kmfras/lickometer/Janak Lab SfN CeA Alcohol Poster 2019.pdf

# Encoding and enhancement of the motivation to consume alcohol by the central nucleus of the amygdala

*These authors contributed equally to this project 1: Department of Psychological and Brain Sciences, Krieger School of Arts and Sciences, 2: The Solomon H. Snyder Department of Neuroscience, Johns Hopkins School of Medicine, 3: Kavli Neuroscience Discovery Institute, Johns Hopkins School of Medicine, Johns Hopkins University
Introduction | Results

# Summary

# Methods

# Kurt M. Fraser¹*, Tabitha H. Kim¹*, David J. Ottenheimer² , & Patricia H. Janak¹,2,3

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
er Clu

ster

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
er Clu

ster

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
er Clu

ster

0

50

100

150

Clu

sters

0

50

100

150

Clu

sters

0

50

100

150

Clu

sters

Maltodextrin vs.
Maltodextrin

Sucrose vs.
Maltodextrin

Sucrose vs.
A | B | C | Maltodextrin
D | E | F

Motivation

Palatability
Maltodextrin vs.
Maltodextrin

Sucrose vs.
Maltodextrin

Sucrose vs.
Maltodextrin

ChR2 GFP
Laser Option
Control Option

### Optogenetic stimulation of the central amygdala alters preference between two objectively equal rewards

- Central amygdala neurons are modulated by the consumption of alcohol, both movements related to the pursuit of alcohol and the licking action required to consume alcohol.
- Neurons within the central amygdala are tuned to the licking cycle and exhibit rhythmic firing during alcohol consumption.
- Closed-loop optogenetic excitation of the central amygdala promoted consumption of the laser-paired option when the other option was equivalent. Stimulation was able to increase alcohol consumption when sucrose was available and enhance motivation to consume adulterated bitter alcohol.
- We observed modest self-stimulation of the central amygdala, perhaps owing to alcohol-induced plasticity resulting from voluntary alcohol consumption.

The central amygdala has been implicated in the promotion of alcohol consumption primarily following dependence through processes associated with the generation of a prolonged negative affective state that is alleviated by alcohol consumption.

It has remained unclear, however, how the central amygdala is involved in the initial motivation to consume alcohol prior to the onset of physical dependence.

If the central amygdala contributes to alcohol consumption produced by appetitive motivational processes, then it is possible that prolonged alcohol consumption can co-opt these appetitive mechanisms and provide a mechanism for the transition to compulsive alcohol consumption and alcohol abuse.

The central amygdala is an ideal site for such hypothesized alcohol-induced plasticity as it receives direct input from brainstem, thalamic and cortical gustatory regions and projects to affective processing structures like the bed nucleus of the stria terminalis, homeostatic control centers like the lateral hypothalamus, and brainstem taste centers such as the parabrachial nucleus and nucleus of the solitary tract.

We investigated the involvement of the central amygdala in the control of alcohol consumption by making use of in vivo electrophysiology to identify correlates of alcohol consumption in the central amygdala and optogenetics to tease apart mechanisms by which the central amygdala may promote the consumption of alcohol despite the availability of more preferred options.

Supported by NIH Grants R01 AA026306, AA027213 to PHJ and F31 DA046136 to KMF

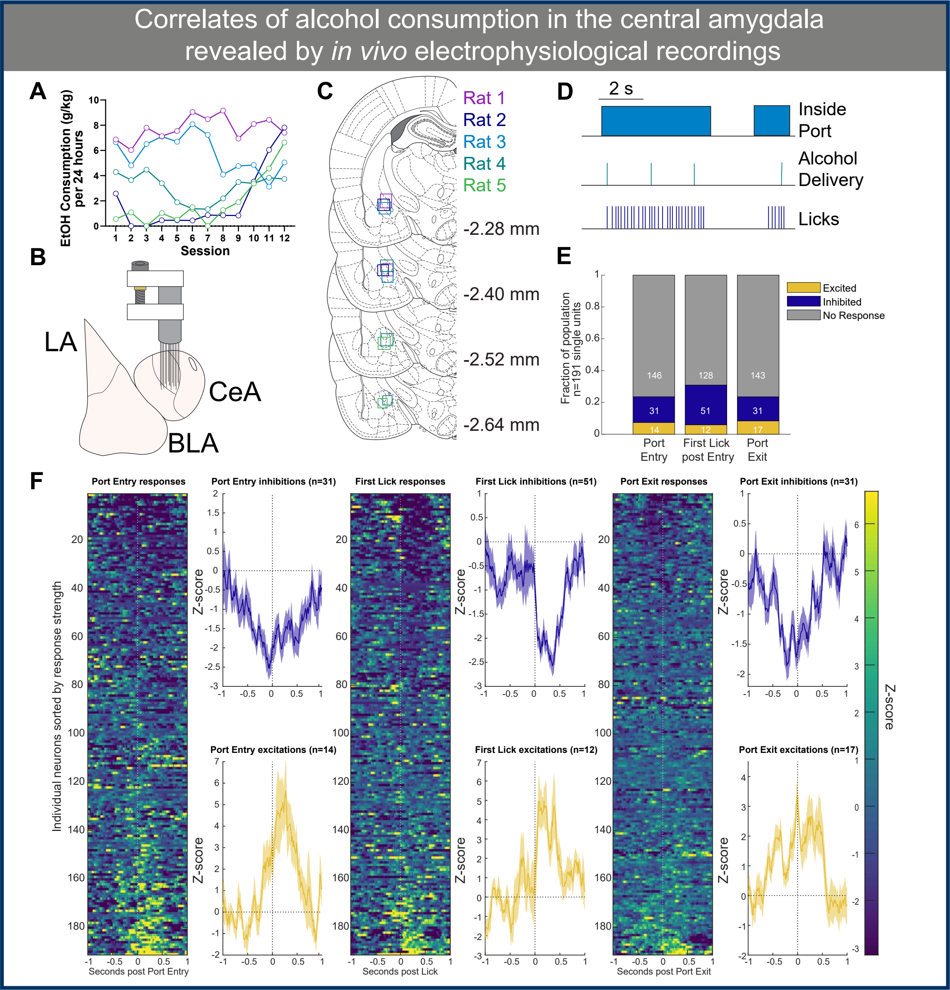
[picture p1: figure]
Rat 1 Rat 2 Rat 3 Rat 4 Rat 5; Port Entry responses; Seconds post Port Entry; First Lick responses; Seconds post Lick; Port Exit responses; Seconds post Port Exit; Z-score; Port Entry inhibitions (n=31); Port Entry excitations (n=14); First Lick inhibitions (n=51); First Lick excitations (n=12); Port Exit inhibitions (n=31); Port Exit excitations (n=17); CeA BLA; Inside Port Alcohol Delivery; Licks; Session; tio; Port Entry; First Lick post Entry; Port Exit; Fraction of population; Excited Inhibited No Response; n=191 single units

### Correlates of alcohol consumption in the central amygdala revealed by in vivo electrophysiological recordings

@Kurt_Fraser
@JanakLab
kfraser3@jhu.edu

Individual neurons sorted by response strength

-2.16 mm

-2.28 mm

-2.40 mm

-2.52 mm

-2.64 mm

-2.76 mm

GFP

ChR2

A B

C

GFP | ChR2-eYFP

DAPI
GFP

1 2 3 4 5 6 7 8 9 10 11 12 13 14 15

0

5

10

Session

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
ChR2

n=6

n=8

DAPI
YFP
5x | 10x
CeA | BLA | BLA

CeA

473 nm
8-12 mW
1s, 20 Hz
A | B | Example ChR2 Rat

Example GFP Rat

10% Ethanol
+ Laser

10% Ethanol

10% Ethanol
+ Laser

10% Ethanol

Time (seconds)

0 | 500 | 1000 | 1500 | 1800
H2O | Malt
0.6062
0.3185
0.2329
0.0856
0.2893

0.1728
0.3795
0.1246

0.1655
0.3453
0.448
| 0.4112

0.0351

H2O | Malt
0.1301
0.042
0.1048
0.0568
0.0312

0.0063
0.3265
0.0374

0.0641
0.2187
0.3417
| 0.0078

0.0934

Laser Paired
Bottle

14.2% Sucrose

10% Ethanol

10% Ethanol
+ 100 μM Quinine

Non-Laser Paired Bottle

14.2% Sucrose | 10% Ethanol | 10% Ethanol + 100 μM Quinine

C D

ChR2 GFP
Laser Option
Control Option

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
14.2% Sucrose

10% Ethanol

10% Ethanol
+ 100 μM Quinine
Motivation | Palatability

Suc
Alc
AlcQ

Laser

Suc | Alc | AlcQ

No Laser

Total Clusters

0

0.5

1
Suc
Alc
AlcQ

Laser

Suc | Alc | AlcQ

No Laser

Average Licks in Clusters

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
1000

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
ChR2 GFP
Active Responses
Inactive Responses

0

1000

2000

3000

4000

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
1000

1500

2000

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
1000

2000

3000

4000

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
A | B | C
D | E | F
G | H | I

Empty Bottles

Water in Bottles

FR1 Nose Poke

E F

### Central amygdala neurons are entrained to the frequency of licking that occurs during alcohol consumption

### Closed-loop optogenetic stimulation of the central amygdala enhances motivation to consume the preferred available option

### Optogenetic control of the central amygdala in rats with a history of alcohol intake in the homecage

### Optogenetic self-stimulation of the central amygdala is modest in rats with a history of alcohol consumption

How much more does stimulation enhance laser bottle preference in ChR2 rats relative to GFP rats? effect size | effect size

Do you want the code and
instructions for the lickometer? A reprint of this poster?
How-to guide, arduino code, and MATLAB analysis code
for lickometer generated data all available at :
github.com/kmfras/lickometer

Number of neurons

Licking Coherence
Tongue out
n=68

Tongue in
n=34

Seconds from lick

Coherent neurons (n=104) Sorted by
Time of Post Lick Excitation
-0.5 | 0 | 0.5
Time (sec)

0

10

20

SPK23a
Coherence = 0.9587
Raster aligned to
Inidividual Licks Firing Rate (Hz)

A

D E

B Median Coherence
0.39

C

Normalized Activity

0 0.1 0.2 0.3 0.4 0.5 0.6 0.7 0.8 0.9 1 0

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
-0.3 | -0.2 | -0.1 | 0 | 0.1 | 0.2 | 0.3

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
0 | 0.02 0.04 0.06 0.08 0.1 | 0.12 0.14 0

5

10

15

20

25

30

Number of neurons

Time (s) of peak activity relative to tongue contacting liquid

*

* | *

*

*

*

* *

*

*

*

For in vivo electrophysiology experiments male Long Evans rats (n=5) were allowed to drink 15% ethanol in the homecage for 4 weeks on an every other day intermittent access schedule. They were then implanted with 16-wire drivable bundles of tungsten electrodes above the central amygdala. During recording sessions rats could freely enter a port where a cumulative presence of 2 seconds would trigger a delivery of 10% ethanol.

For optogenetic experiments male Long-Evans rats (n=14) first received infusions of 0.5 μL AAV5-hsyn-ChR2-eYFP or AAV5-hsyn-GFP into the central amygdala and then subsequent implantation of an optic implant above the central amygdala. Rats were then allowed to drink 15% ethanol on an every other day intermittent access schedule for 5 weeks. They were then extensively handled and accustomed to tethering needed for the optogenetic stimulation. During testing rats had access to two bottles for 30 minutes in a modified homecage. Licks were recorded from each bottle using a custom, low-cost lickometer and one bottle triggered stimulation on the first lick made each second.

* | *

Rat 1

Rat 2

Rat 3
Rat 4

Rat 5

Individual Session
Average

*
